vrsp05/esp32-vector-rover/docs/math_dco/Vector Rover Math Documentation.pdf

# 2D Vector Navigation Math: Spin-then-Drive Model

The system takes a 2D Cartesian coordinate vector (v = Xî + Yĵ) and calculates the required physical maneuvers. The rover is physically placed facing the positive X-axis (0°).

## Phase 1: Calculus Vector Math

- Magnitude (Distance): M = √(X² + Y²)
- Target Angle (Heading): θ = atan2(Y, X) × (180 / π)

## Phase 2: Translation to Hardware Timers

The mathematical values are converted into physical motor run-times in milliseconds using calibration constants tuned to the floor's friction.

- Spin Duration: Spin Duration = |θ| × SPIN_MS_PER_DEGREE
- Drive Duration: Drive Duration = M × DRIVE_MS_PER_UNIT

## Phase 3: Physical Execution

The rover uses a state machine to evaluate the target angle and determine the direction of rotation.

- Positive Angle: The rover spins Left (Counter-Clockwise).
- Negative Angle: The rover spins Right (Clockwise).
- Zero Angle: The rover skips the spin phase and immediately drives forward.
