vrsp05/esp32-vector-rover/hardware/3d_prints/Case.3mf

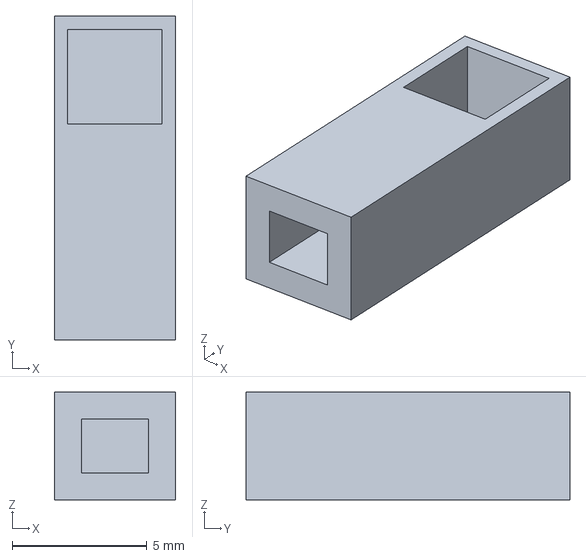
[picture p2: CAD file, 2026-10-19]
hardware/3d_prints/Case.3mf
4.50 x 12.0 x 4.00 mm
