vrsp05/esp32-vector-rover/hardware/3d_prints/T-Bracket_Mount.stl

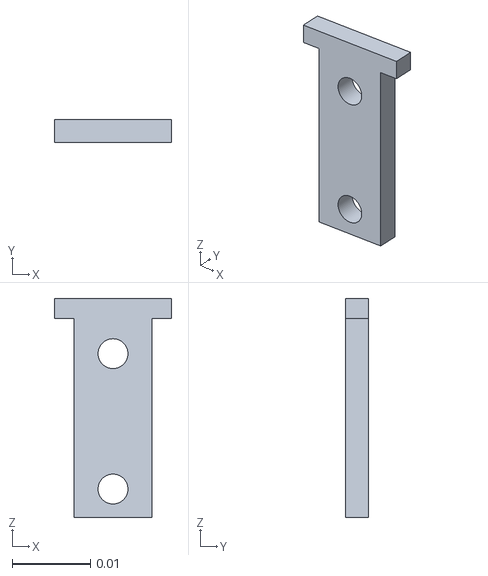
[picture p3: CAD file, 2026-10-03]
hardware/3d_prints/T-Bracket_Mount.stl
0.015 x 0.00292 x 0.0279
