vrsp05/esp32-vector-rover/hardware/3d_prints/Camera_Mount.stl

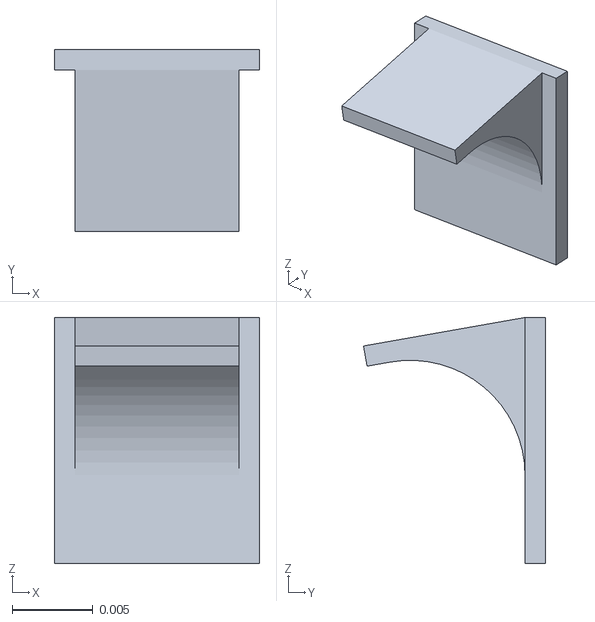
[picture p4: CAD file, 2026-10-03]
hardware/3d_prints/Camera_Mount.stl
0.0127 x 0.0113 x 0.0152
