vrsp05/esp32-vector-rover/(commit log)

2026-10-03 copied resources
    [Camera_Mount.stl, T-Bracket_Mount.stl, partitions.csv]
2026-10-19 fixed code of angle and spin time
    [rc_car_main.ino]
2026-10-19 updated documentation to match project
    [Case.3mf]
